derekmccallum/camera_boom_driver/README.md

# camera_boom_driver

ESP32 firmware to motorise a ceiling-mounted camera boom. The boom swings horizontally around a vertical pole through up to 120 degrees, driven by a stepper motor and a GT2 belt on a 200 mm lazy-susan bearing. Control is by two physical buttons (go to 0, go to 120) and, later, a tablet web UI served by the ESP32 over its own WiFi network. A second (tilt) axis may be added later.

Design decisions, safety requirements and working rules live in [AGENTS.md](AGENTS.md). Wiring and bring-up are in [docs/wiring.md](docs/wiring.md).

## Wiring diagram

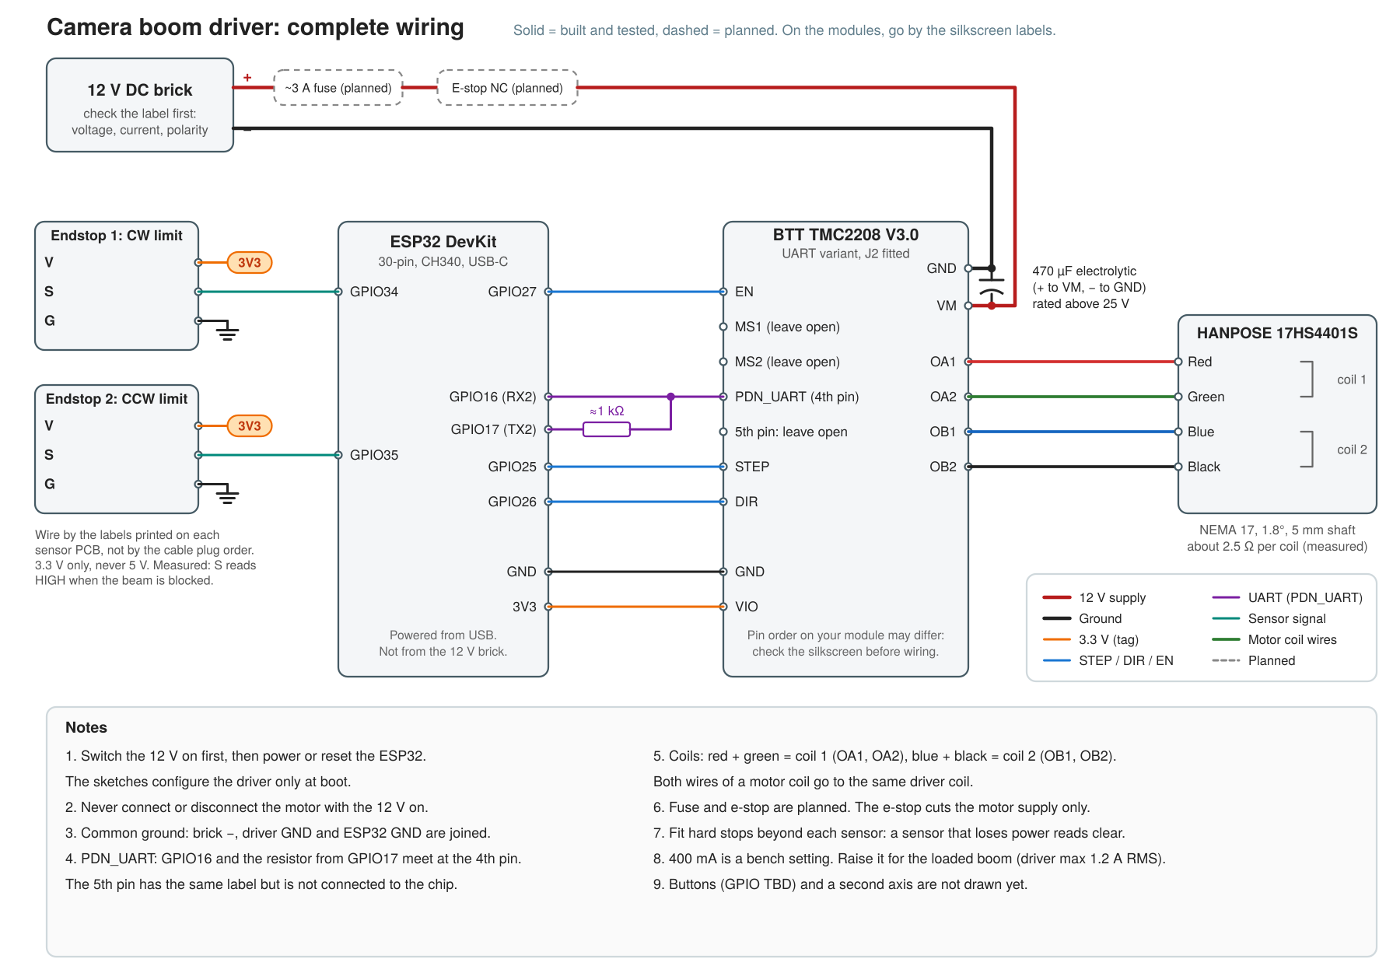
[picture p1: docs/wiring_diagram.png]
Complete wiring diagram


Solid lines are built and tested; the fuse and e-stop are drawn dashed because they are planned. The 12 V brick's label, the driver's pin order and the TX resistor value are not confirmed, so go by the silkscreen on each module.

## Sketches

Built up in small steps, so each hardware or software unknown is proven on its own. Arduino needs one sketch per folder.

| Sketch | Purpose | State |
|---|---|---|
| `01_blink_button` | Toolchain, upload, serial, input reading | Earlier version tested on hardware |
| `02_opto_endstop` | Optical limit sensor (active-HIGH as wired) | Earlier version tested; polarity constant since corrected, not re-run |
| `03_wifi_ap_test` | Joins home WiFi (DHCP), serves test page; falls back to own access point | Station mode tested on hardware (joins home WiFi, DHCP). AP fallback untested |
| `04_tmc2208_uart_test` | TMC2208 UART read/write check, no motion | Tested on hardware: PASS |
| `05_first_motor_move` | First motor motion: unloaded, 400 mA, slow, serial-commanded finite moves, idle auto-disable | Tested on hardware: turns smoothly, no driver faults (3200 steps/rev assumed) |
| `06_limit_shuttle` | Unloaded, 400 mA. Auto-starts after a 5 s countdown: seeks the CW sensor, measures travel to the CCW sensor, then shuttles between them forever, logging the position error at each hit | UNTESTED on hardware (compiles for ESP32 Dev Module). Sensors measured active-HIGH on the bench (conflicts with the active-LOW note for sketch 02). Clockwise DIR level unverified |

"Earlier version tested" means the original single-file sketch ran on the real board. Sketches 01 to 03 have since been split into a `config.h` per sketch and have not been recompiled, so report anything that fails to build.

Not yet written: homing in the final form, absolute moves in degrees, buttons, the web UI. Sketch 06 contains a first seek-to-limit, but it is untested.

## Setup

- Arduino IDE 2.x with the **esp32 by Espressif Systems** board package. Pin the core version once a combination works; libraries lag behind new cores.
- Board: **ESP32 Dev Module** (classic ESP32, not S3 or C3).
- **Upload speed: 115200.** Uploads failed at 921600 on this CH340 board.
- Libraries (Library Manager): **TMCStepper** now; **FastAccelStepper** when motion is added.
- If the upload hangs on "Connecting...", hold the BOOT button until it starts.

## WiFi credentials

Your network name and passwords are not committed. Before building sketch 03:

```
cd sketches/03_wifi_ap_test
cp secrets.example.h secrets.h     # then edit secrets.h
```

`secrets.h` holds `WIFI_SSID`, `WIFI_PASSWORD` and `AP_PASSWORD` (for the fallback access point) and is gitignored. The ESP32 only joins 2.4 GHz networks. The serial monitor prints the DHCP address it received; `http://boom.local` also works where mDNS is supported.

## Safety

The boom swings at head height. A hardware e-stop that cuts the motor supply must work independently of the firmware and WiFi. Never connect or disconnect the motor while the driver is powered. Treat all ratio, torque and current figures as estimates until calibrated on the real arm.
