derekmccallum/camera_boom_driver/sketches/01_blink_button/config.h

// config.h - pins for the blink + button test.
#pragma once

constexpr int PIN_LED = 2;    // onboard LED on most 30-pin boards (strapping pin: fine for an LED only)
constexpr int PIN_BTN = 32;   // optional button between this pin and GND (internal pull-up)
