derekmccallum/camera_boom_driver/(commit log)

2026-11-11 Add untested TMC2208 UART test sketch
2026-11-11 Add sketches 01-03, README and wiring notes
